OmegaNalphA/Slithery-Arduino-Snake/README.md

# Slithery-Arduino-Snake
Project for EE3 Fall '16 at UCLA, by Anshul Aggarwal and Martin Kong

Snake game that ports to arduino to be able to play physically.

Demo of the finished project:
https://youtu.be/nKSCjAc0CNc
