OmegaNalphA/Slithery-Arduino-Snake/(commit log)

2016-11-10 New game ending, working on flashing numbers and way to integrate with arduino
2016-11-28 Board testing intro
    Used to make sure we can accurately drive the arduino
2016-11-29 Arduino V1
2016-11-29 C code to Arduino
2016-12-03 Sketches for Arduino
2016-12-04 Main Arduino Code
2016-12-04 Primary Arduino sketch
2016-12-04 Custom Arduino library made from C++ code
